atiretoo/gaming_table/docs/cut_list_and_bom.md

# Bill of Materials (BoM) & Cut List: Modular Gaming Table (Rev 7)

**Table Envelope**: 27.0" (685.8 mm) Width $\times$ 56.0" (1422.4 mm) Length $\times$ 30.0" (762 mm) Total Height  
**Design**: Option 3 Final (Recessed Base, Floating Leaf Chamfers, Tapered Legs, Outside Accessory Track)  
**Finish**: Natural Baltic Birch Plywood with De-waxed Shellac (No Edge Banding, No Veneer)  

---

## 1. Dimensional & Architectural Summary

- **Tabletop Leaves**: 27.0" $\times$ 56.0" (Two pieces @ 27.0" $\times$ 28.5" with 12 mm half-lap seam).
- **Underside Chamfer**: 12 mm $\times$ 45° reverse chamfer around outer perimeter (creates floating top & finger lift).
- **Leg Geometry**:
  - $54 \times 54$ mm at apron shoulder; outer faces plumb with 45° miter.
  - **Two inner faces tapered** from $Z = 657\text{ mm}$ down to $Z = 0$, ending at a slender $34 \times 34$ mm foot.
- **Apron Box**: 22.75" (577.8 mm) Width $\times$ 51.75" (1314.4 mm) Length $\times$ 3.43" (87 mm) Height.
- **Gaming Vault Play Area**: 21.33" (541.8 mm) Width $\times$ 50.33" (1278.4 mm) Length $\times$ 3.0" (75 mm) Depth.
- **Apron Top Rim**: 9 mm fillet on outer top edge; 2.5 mm chamfer on inner top edge (forearm comfort).
- **Accessory Rail**: 1/4" throat $\times$ 1/2" cavity T-slot routed along outside apron face.

---

## 2. Complete Cut List

### A. Tabletop (18 mm Baltic Birch - Sheet 1)
| Part # | Description | Qty | Thickness | Width | Length | Notes / Joinery Details |
| :---: | :--- | :---: | :---: | :---: | :---: | :--- |
| **T1** | Tabletop Leaf (Left) | 1 | 18 mm | 27.0" (685.8 mm) | 28.5" (724 mm) | Upper 12mm $\times$ 9mm half-lap rebate; 3.5mm $\times$ 2.0mm silicone groove; 12mm underside perimeter chamfer |
| **T2** | Tabletop Leaf (Right) | 1 | 18 mm | 27.0" (685.8 mm) | 28.5" (724 mm) | Lower 12mm $\times$ 9mm half-lap rebate; 12mm underside perimeter chamfer |

---

### B. Apron Box & Center Beam (18 mm Baltic Birch - Sheet 1)
| Part # | Description | Qty | Thickness | Width | Length | Notes / Joinery Details |
| :---: | :--- | :---: | :---: | :---: | :---: | :--- |
| **A1** | Long Side Aprons | 2 | 18 mm | 3.43" (87.0 mm) | 51.75" (1314.4 mm) | Outside T-slot groove; 6mm center dado; 9mm top-outer fillet; 2.5mm top-inner chamfer |
| **A2** | Short End Aprons | 2 | 18 mm | 3.43" (87.0 mm) | 21.33" (541.8 mm) | Outside T-slot groove; 9mm top-outer fillet; 2.5mm top-inner chamfer |
| **B1** | Removable Center Beam | 1 | 18 mm | 2.95" (75.0 mm) | 21.80" (553.8 mm) | Fits across inner width with 6mm tabs into side dados |
| **L1** | Long Ledger Cleats | 2 | 18 mm | 0.75" (19.0 mm) | 50.25" (1276 mm) | Screwed to inside bottom of long aprons |
| **L2** | Short Ledger Cleats | 2 | 18 mm | 0.75" (19.0 mm) | 19.75" (502 mm) | Screwed to inside bottom of short aprons |

---

### C. Mitered Corner Legs with Inner Tapers (18 mm Baltic Birch - Sheet 1)
*54x54mm finished square at top, inner 2 faces tapered to 34x34mm at floor.*

| Part # | Description | Qty | Thickness | Width | Length | Notes / Joinery Details |
| :---: | :--- | :---: | :---: | :---: | :---: | :--- |
| **LEG-A** | Outer Mitered Ply (Face 1) | 4 | 18 mm | 2.13" (54.0 mm) | 29.29" (744.0 mm) | Full height; one long edge cut at **45° bevel miter**; stays plumb |
| **LEG-B** | Outer Mitered Ply (Face 2) | 4 | 18 mm | 2.13" (54.0 mm) | 29.29" (744.0 mm) | Full height; one long edge cut at **45° bevel miter**; stays plumb |
| **LEG-C** | Inner Core Ply 1 | 4 | 18 mm | 1.42" (36.0 mm) | 25.87" (657.0 mm) | Cut **3.43" (87 mm) shorter** for shoulder; tapered on inner face |
| **LEG-D** | Inner Core Ply 2 | 4 | 18 mm | 0.71" (18.0 mm) | 25.87" (657.0 mm) | Cut **3.43" (87 mm) shorter** for shoulder; tapered on inner face |

*Tip: Cut the 2-face taper on a table saw taper jig after the leg blank is glued and dried.*

---

### D. Gaming Vault Floor (12 mm Baltic Birch - Sheet 2)
| Part # | Description | Qty | Thickness | Width | Length | Notes |
| :---: | :--- | :---: | :---: | :---: | :---: | :--- |
| **V1** | Gaming Vault Floor Panel | 1 | 12 mm | 21.33" (541.8 mm) | 50.33" (1278.4 mm) | Drops onto ledger cleats; 100% clean playing field |

---

## 3. Hardware & Fasteners Bill of Materials

| Item # | Description | Specification | Qty | Purpose |
| :---: | :--- | :--- | :---: | :--- |
| **H1** | Joint Connector Bolts (JCB) | 1/4"-20 $\times$ 1-1/2" Black Socket Flat Head | **8** | Connects apron walls horizontally into leg shoulders |
| **H2** | Knife-Thread Wood Inserts | 1/4"-20 Internal Thread for Plywood | **8** | Installed into inner shoulder faces of legs |
| **H3** | Locating Alignment Dowels | 3/8" (9.5 mm) $\times$ 1-1/4" Brass or Hardwood Pins | **8** | Underside of leaves for horizontal alignment |
| **H4** | Silicone Foam Gasket Cord | 3.0 mm (1/8") Soft Closed-Cell Silicone Sponge Cord | **10 ft** | Pressed into groove along leaf half-lap seam |
| **H5** | Adjustable Leveling Feet | Heavy-duty M8 or 1/4"-20 Threaded Glides + T-Nuts | **4** | Recessed into leg bottoms for floor leveling |
| **H6** | Ledger Assembly Screws | #8 $\times$ 1-1/4" Flat Head Wood Screws | **24** | Fastens ledger cleats to apron rails |
| **H7** | Wood Glue | Titebond II or III Wood Glue (16 oz) | **1** | Mitered leg glue-up and apron frame assembly |

---

## 4. 3D Printed Prototype Test Files

Located in [`models/3d_print/`](file:///c:/Users/atyre/github/gaming_table/models/3d_print):
- **`t_slot_coupon.stl`**: 75 mm $\times$ 60 mm $\times$ 18 mm test block with the exact T-slot channel and mounting screw counterbores.
- **`gravity_hook_clip.stl`**: Functional test clip with gravity hook, fulcrum pad, and integrated card-holding ledge.

**Recommended Print Settings**:
- Layer Height: 0.20 mm
- Perimeters / Walls: 4 walls (for rigidity)
- Infill: 20–25% Gyroid or Grid (PETG or PLA)
- Supports: None needed (designed with self-supporting 45° overhangs)
