atiretoo/gaming_table/models/3d_print/gravity_hook_clip_v2.stl

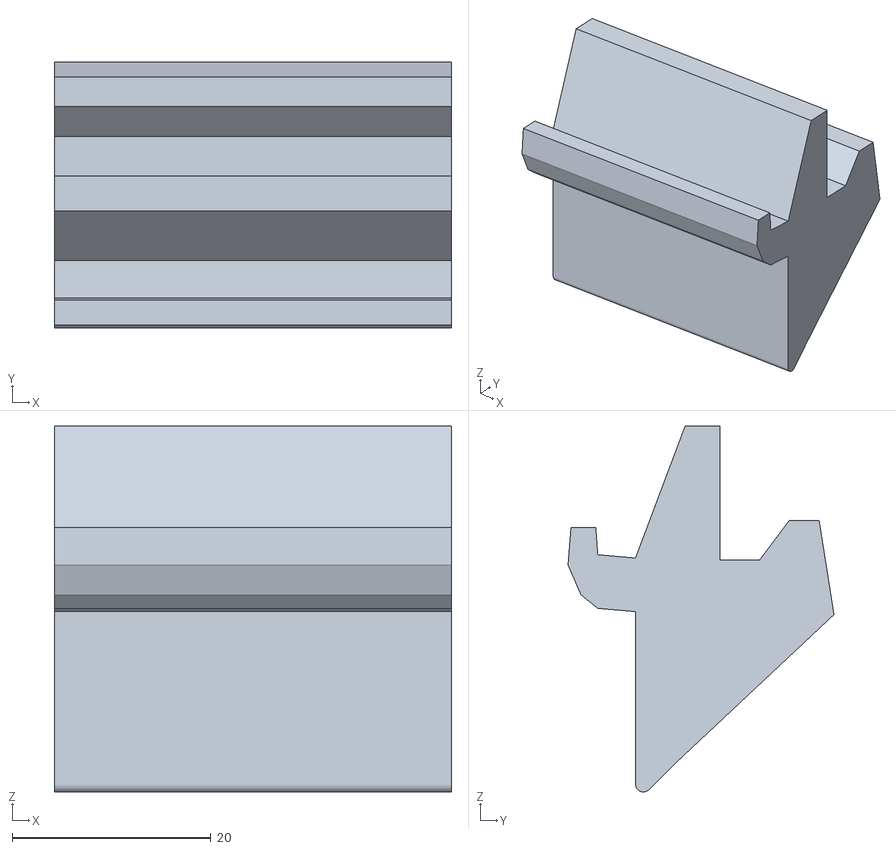
[picture p1: CAD file, 2026-10-18]
models/3d_print/gravity_hook_clip_v2.stl
40.0 x 26.8 x 36.9
