atiretoo/gaming_table/models/3d_print/t_slot_coupon.stl

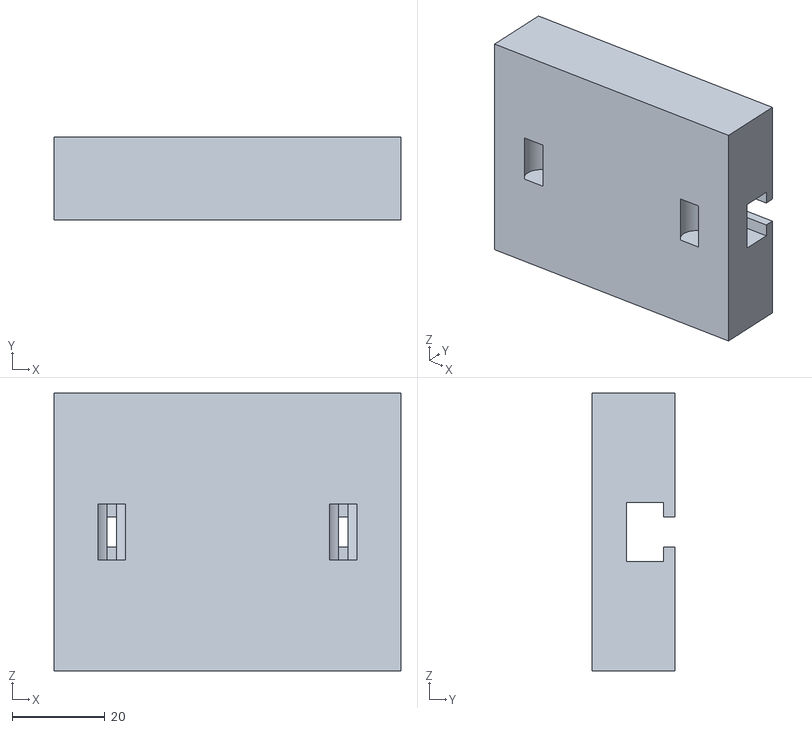
[picture p2: CAD file, 2026-10-18]
models/3d_print/t_slot_coupon.stl
75.0 x 18.0 x 60.0
