atiretoo/gaming_table/(commit log)

2026-10-17 Update table envelope to 27x56, add removable center beam, silicone cord groove, and leg options
2026-10-17 Rev 3: Clarify Option 3 isometric perspective, add chair tuck-in analysis, and detail pre-lamination leg joinery
2026-10-17 Rev 4: Update dining mode model with Option 3 notched legs and closed leaves
2026-10-18 Rev 5: Add Bill of Materials, Cut List, mitered leg construction details, and Shellac finishing guide
2026-10-18 Rev 6: Finalize refined table with floating chamfer, recessed base, filleted/chamfered apron, and outside T-slot rail
2026-10-18 Rev 7: Add inner 2-face leg taper, generate 3D-printable T-slot test coupon and gravity hook STLs
    [gravity_hook_clip.stl, t_slot_coupon.stl]
2026-10-18 Rev 8: Update gravity hook clip to v2 (shorter/thicker shaft, extended 2.6mm grab, 5-deg upward wedge angle, flat vertical fulcrum pad)
    [gravity_hook_clip.stl, gravity_hook_clip_v2.stl]
